vaidastal/DZF-6020-UV-power-addon/README.md

# DZF-6020-UV-power-addon
Addon for DZF-6020 vacuum UV post-curing chamber to adjust light sources and their radiant flux.

---
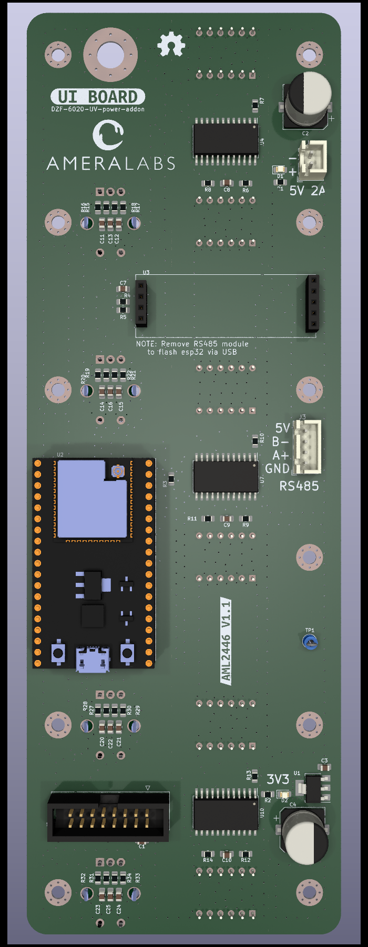
[picture p1: gen/img_3d_ui_front.png]

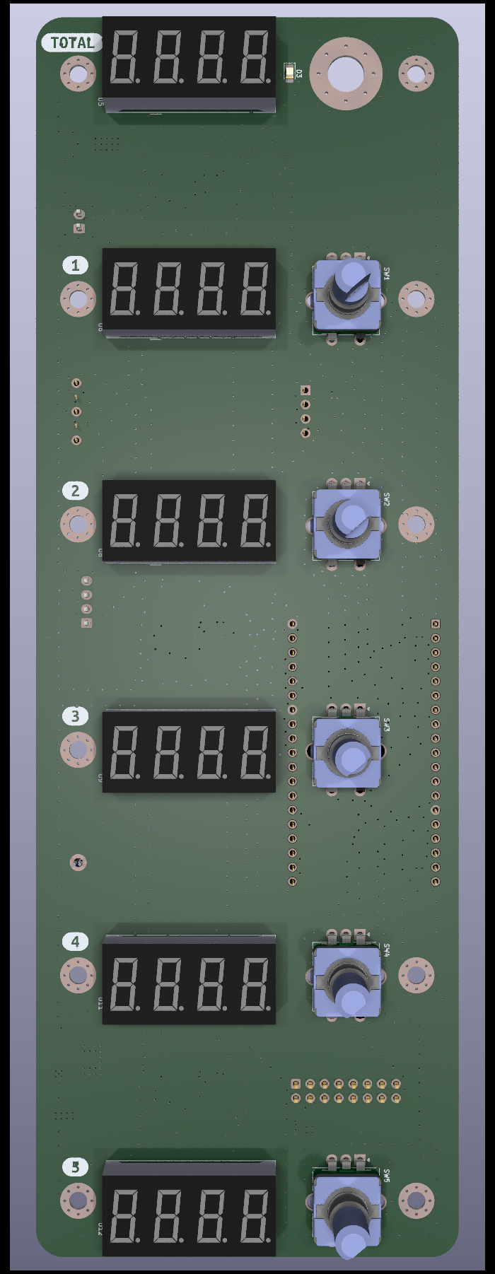
[picture p2: gen/img_3d_ui_back.png]

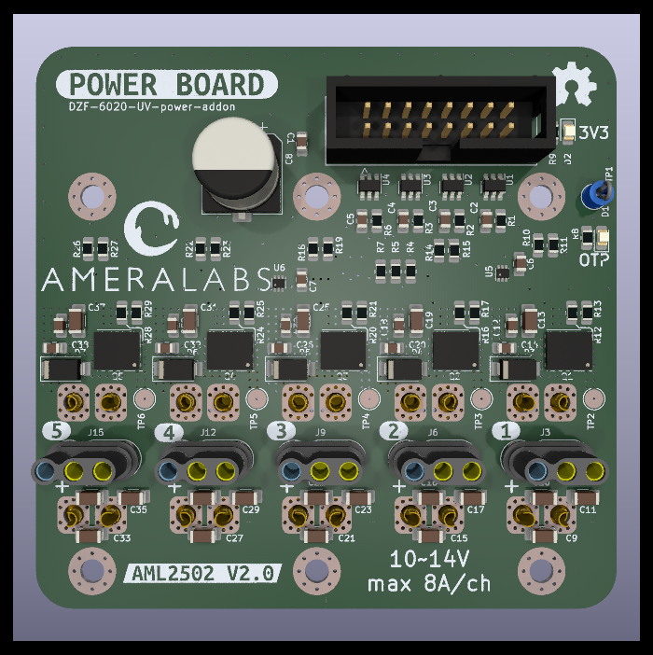
[picture p3: gen/img_3d_pwr_front.png]

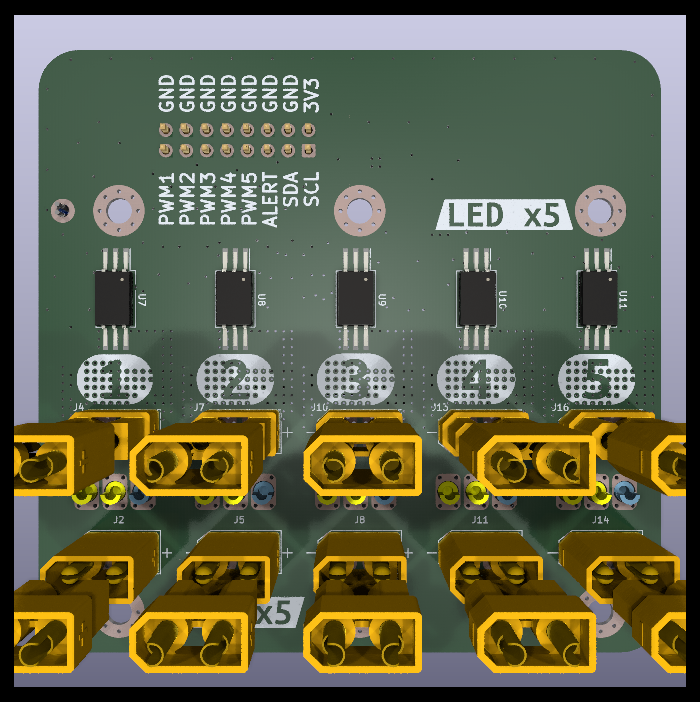
[picture p4: gen/img_3d_pwr_back.png]


Dev NOTE: before commit, run `./kibot.sh` to regenerate documentation, bom, gerbers and other assets.

* [UI schematics](gen/schematics_ui.pdf)
* [power schematics](gen/schematics_pwr.pdf)
* [pcb.pdf with dimensions](gen/pcb.pdf)
