vaidastal/DZF-6020-UV-power-addon/gen/schematics_pwr.pdf

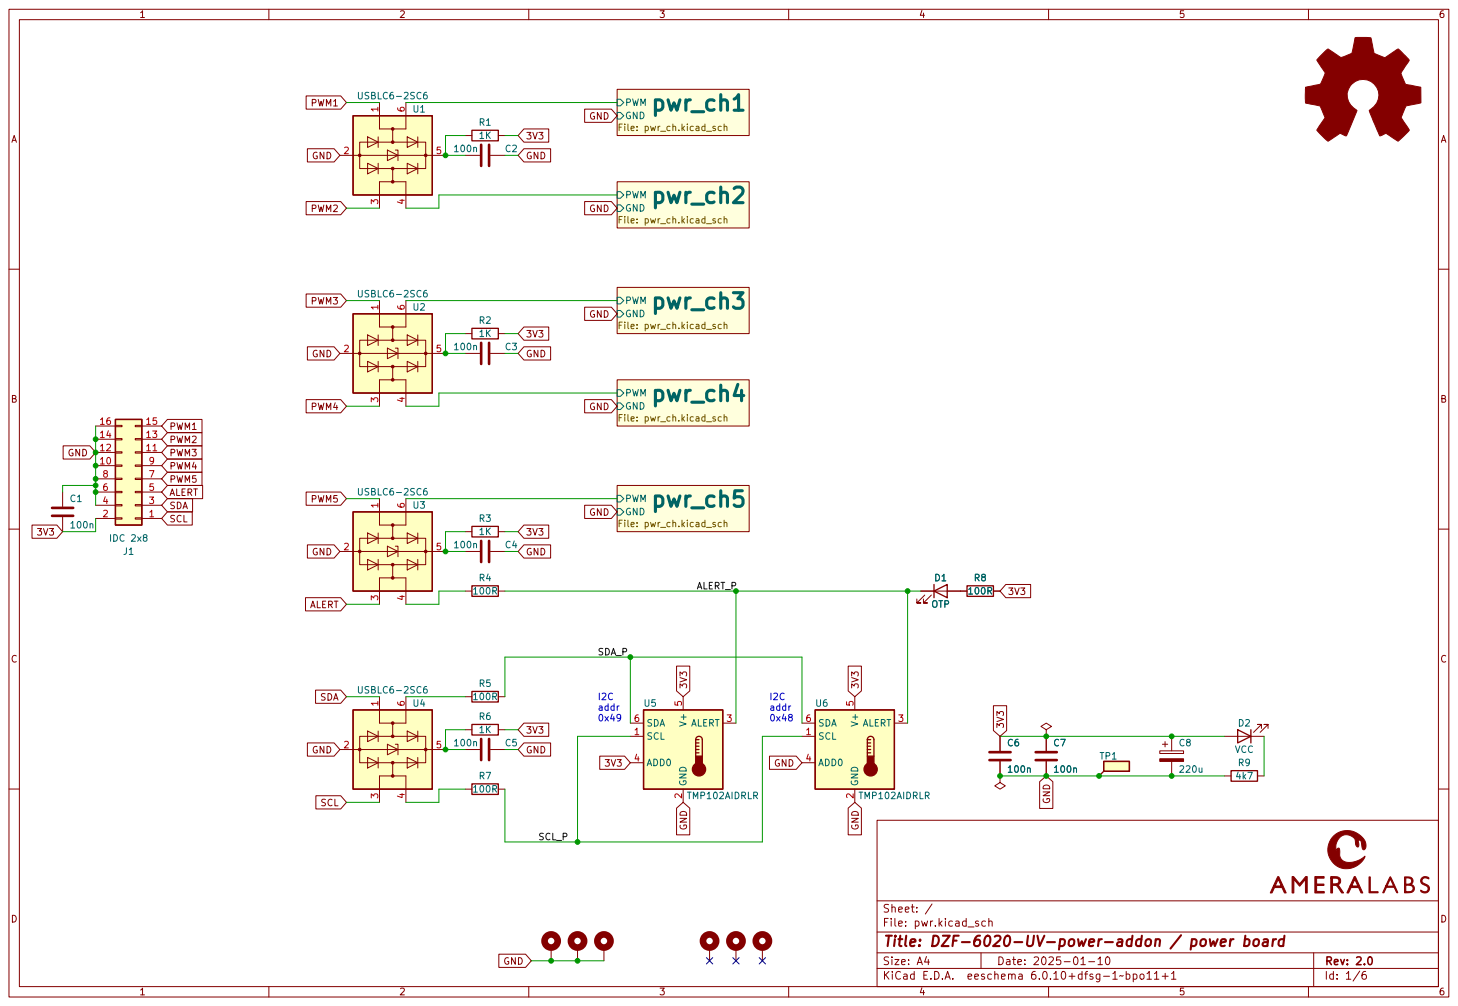
[picture p5: page 1]

File: pwr.kicad_sch Sheet: / PWM

Id: 1/6 Title: DZF-6020-UV-power-addon / power board

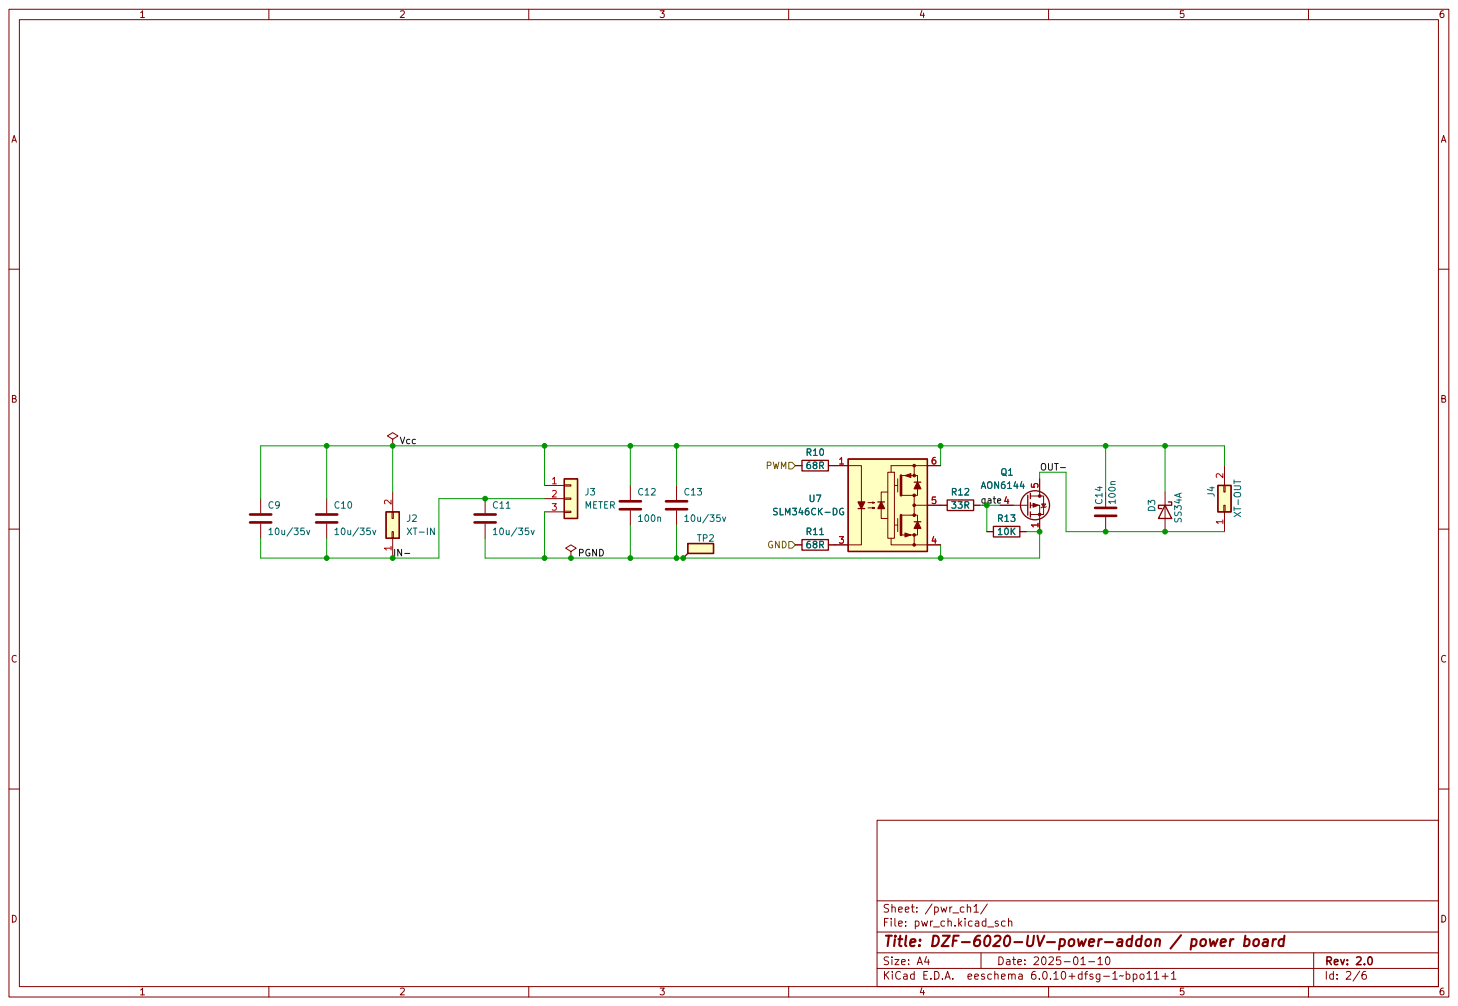
[picture p6: page 2]

File: pwr_ch.kicad_sch
Id: 2/6 Title: DZF-6020-UV-power-addon / power board

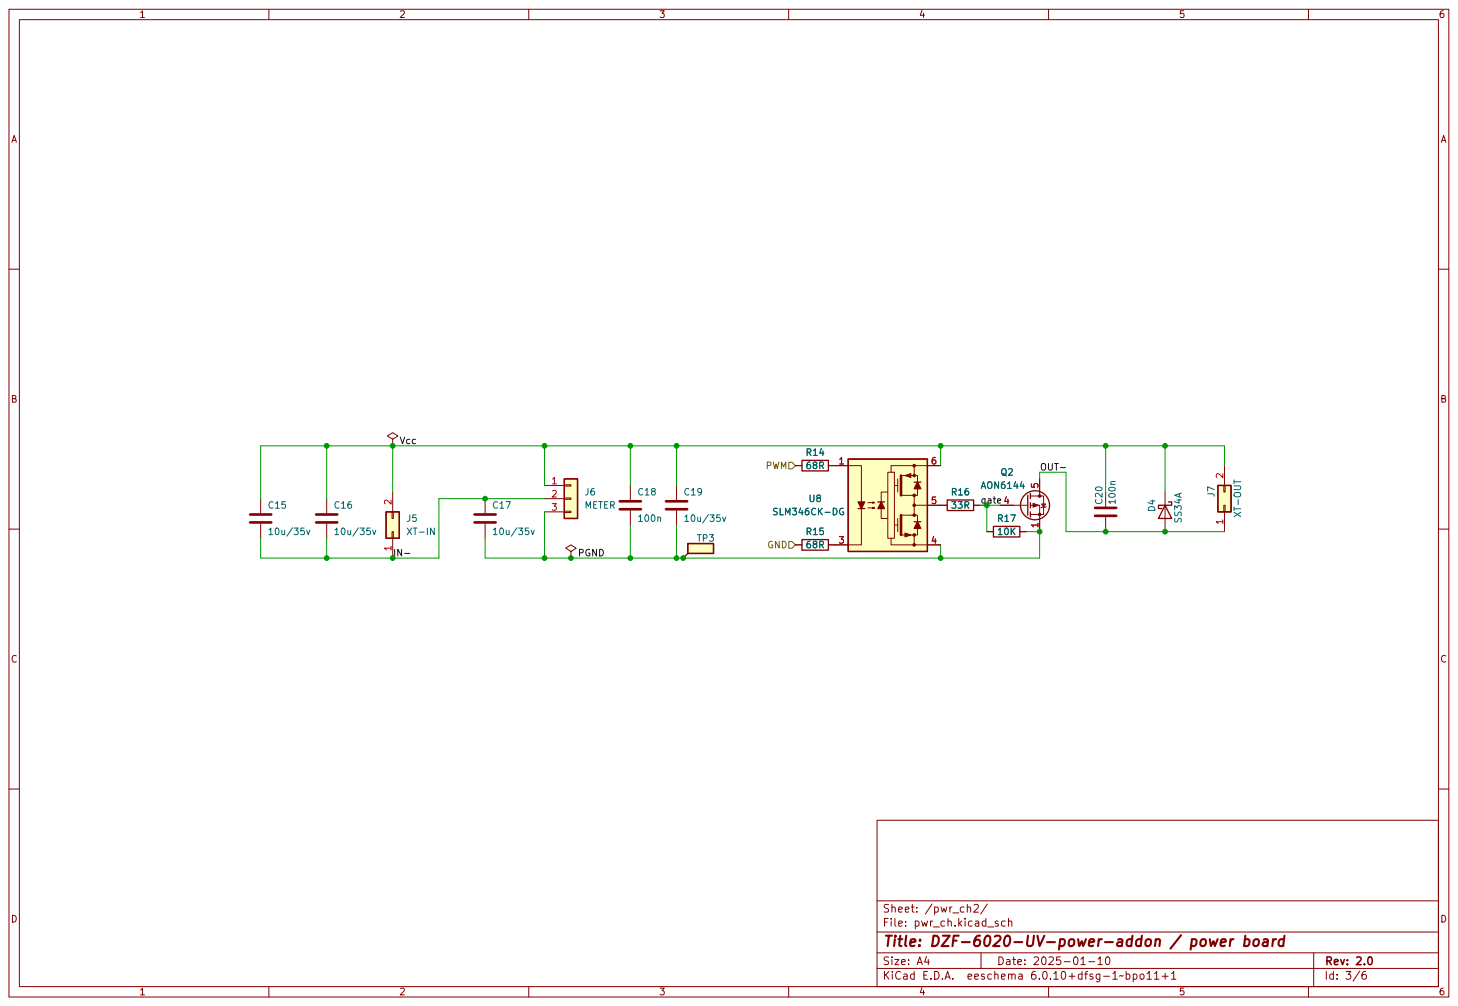
[picture p7: page 3]

File: pwr_ch.kicad_sch
Id: 3/6 Title: DZF-6020-UV-power-addon / power board

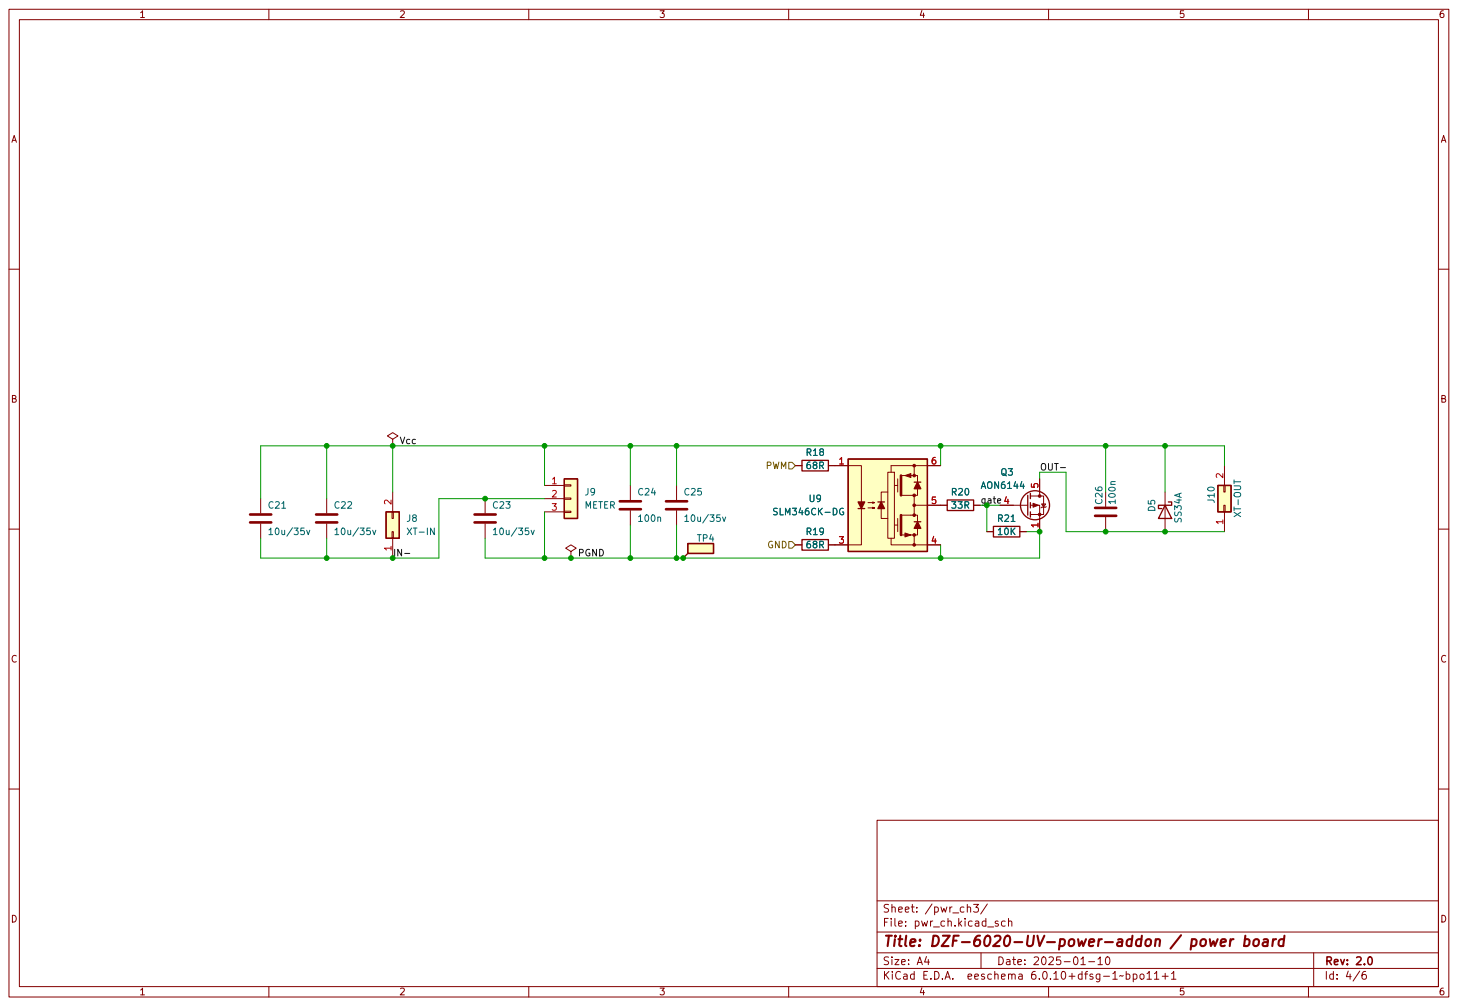
[picture p8: page 4]

File: pwr_ch.kicad_sch
Id: 4/6 Title: DZF-6020-UV-power-addon / power board

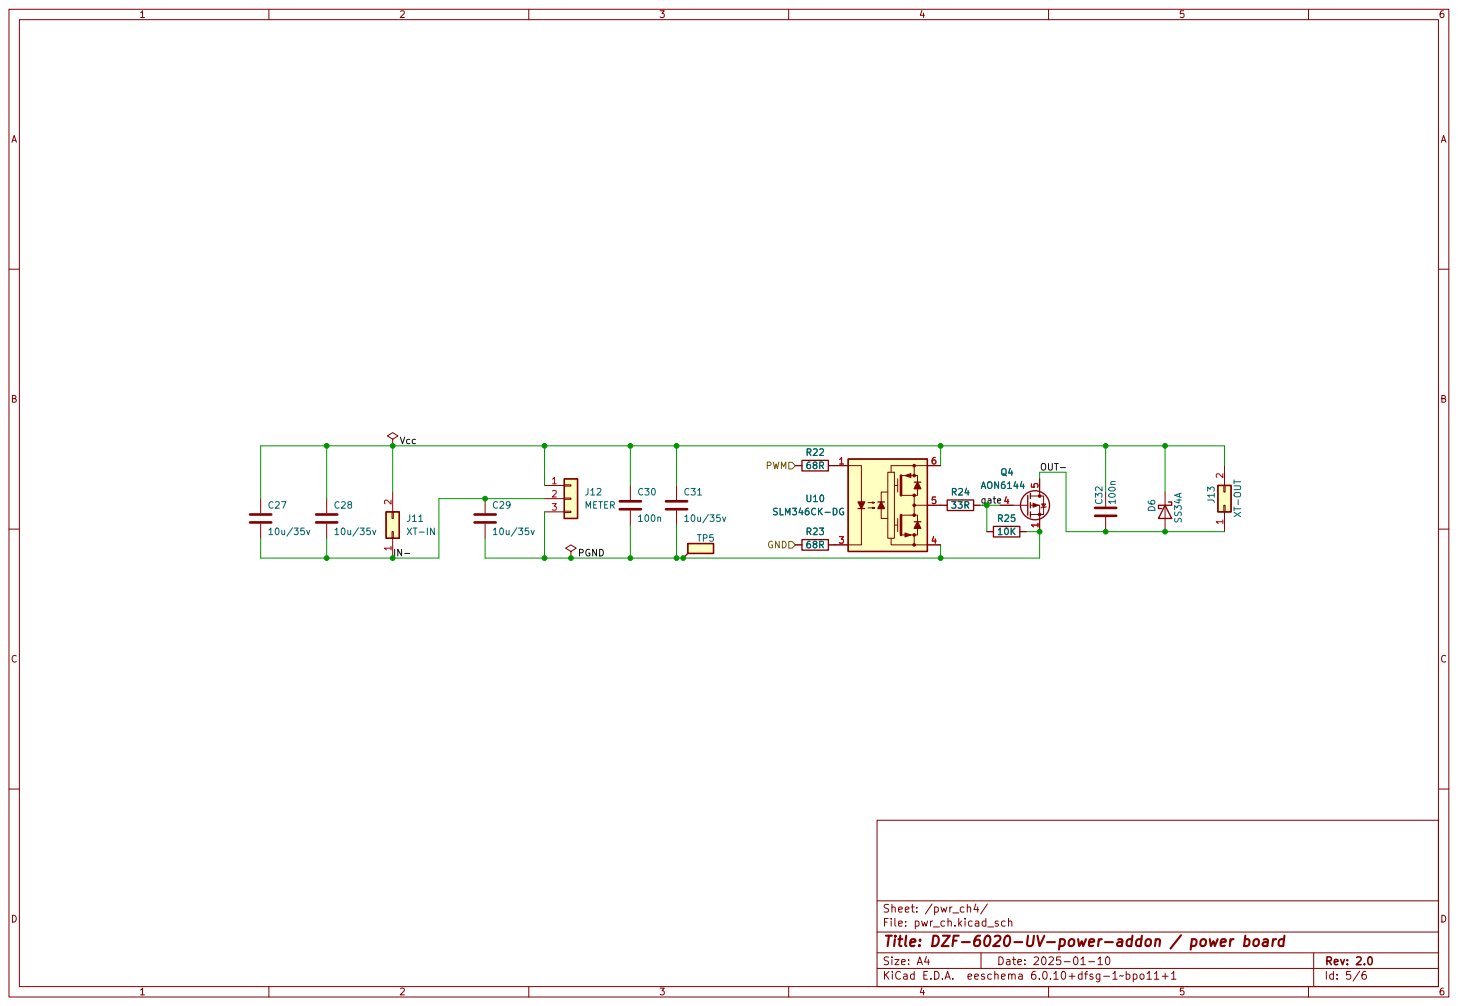
[picture p9: page 5]

File: pwr_ch.kicad_sch
Id: 5/6 Title: DZF-6020-UV-power-addon / power board

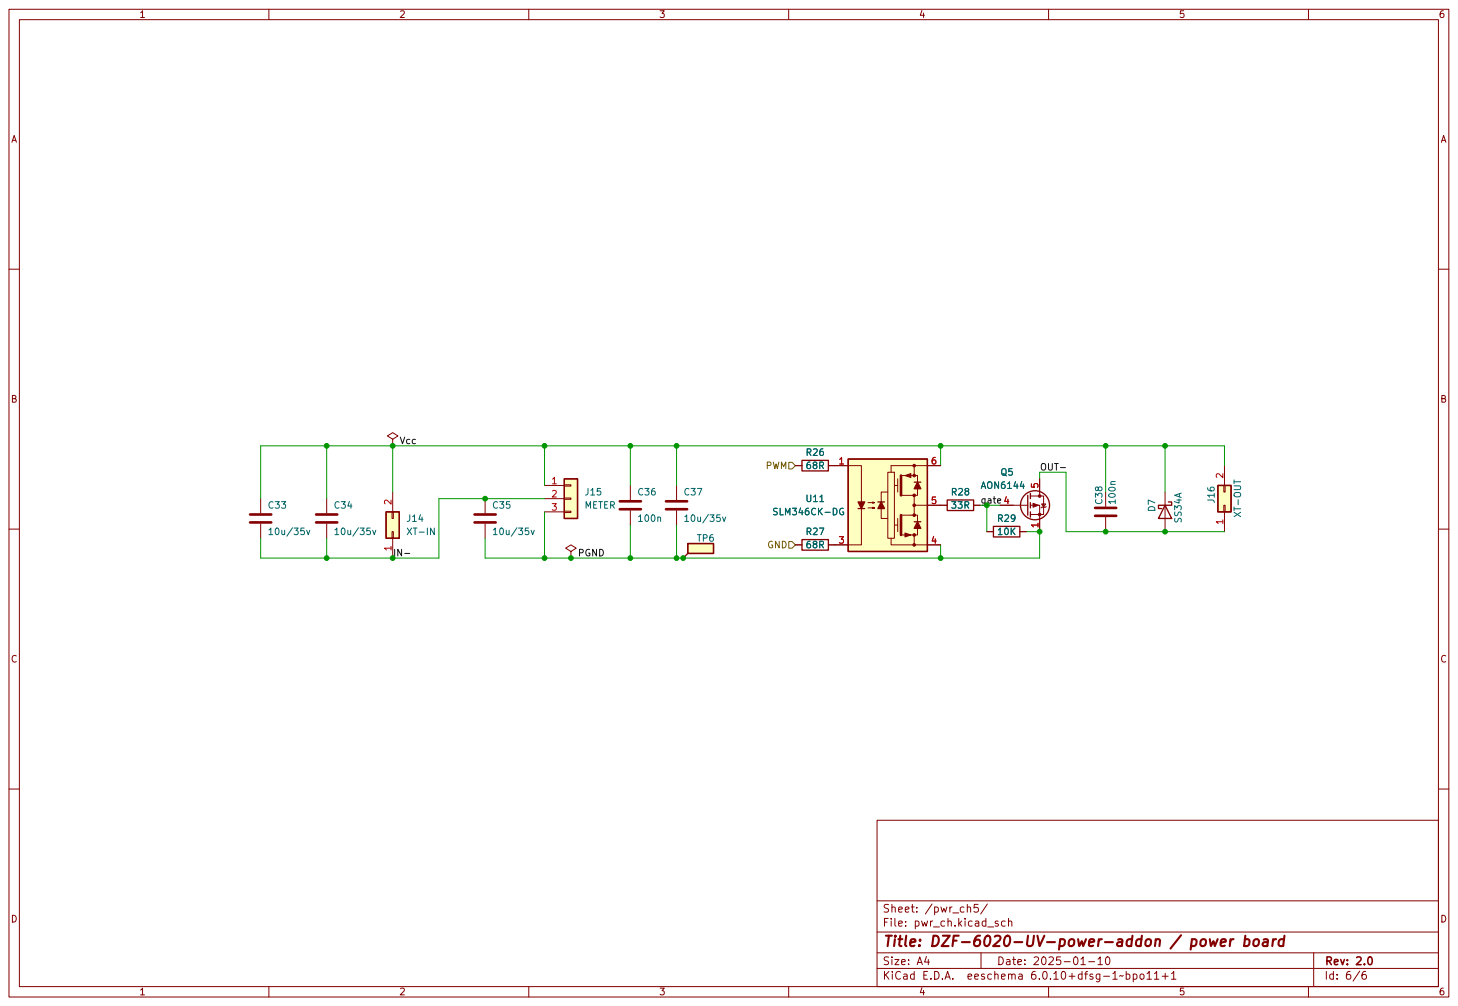
[picture p10: page 6]

File: pwr_ch.kicad_sch
Id: 6/6 Title: DZF-6020-UV-power-addon / power board
