vaidastal/DZF-6020-UV-power-addon/gen/schematics_ui.pdf

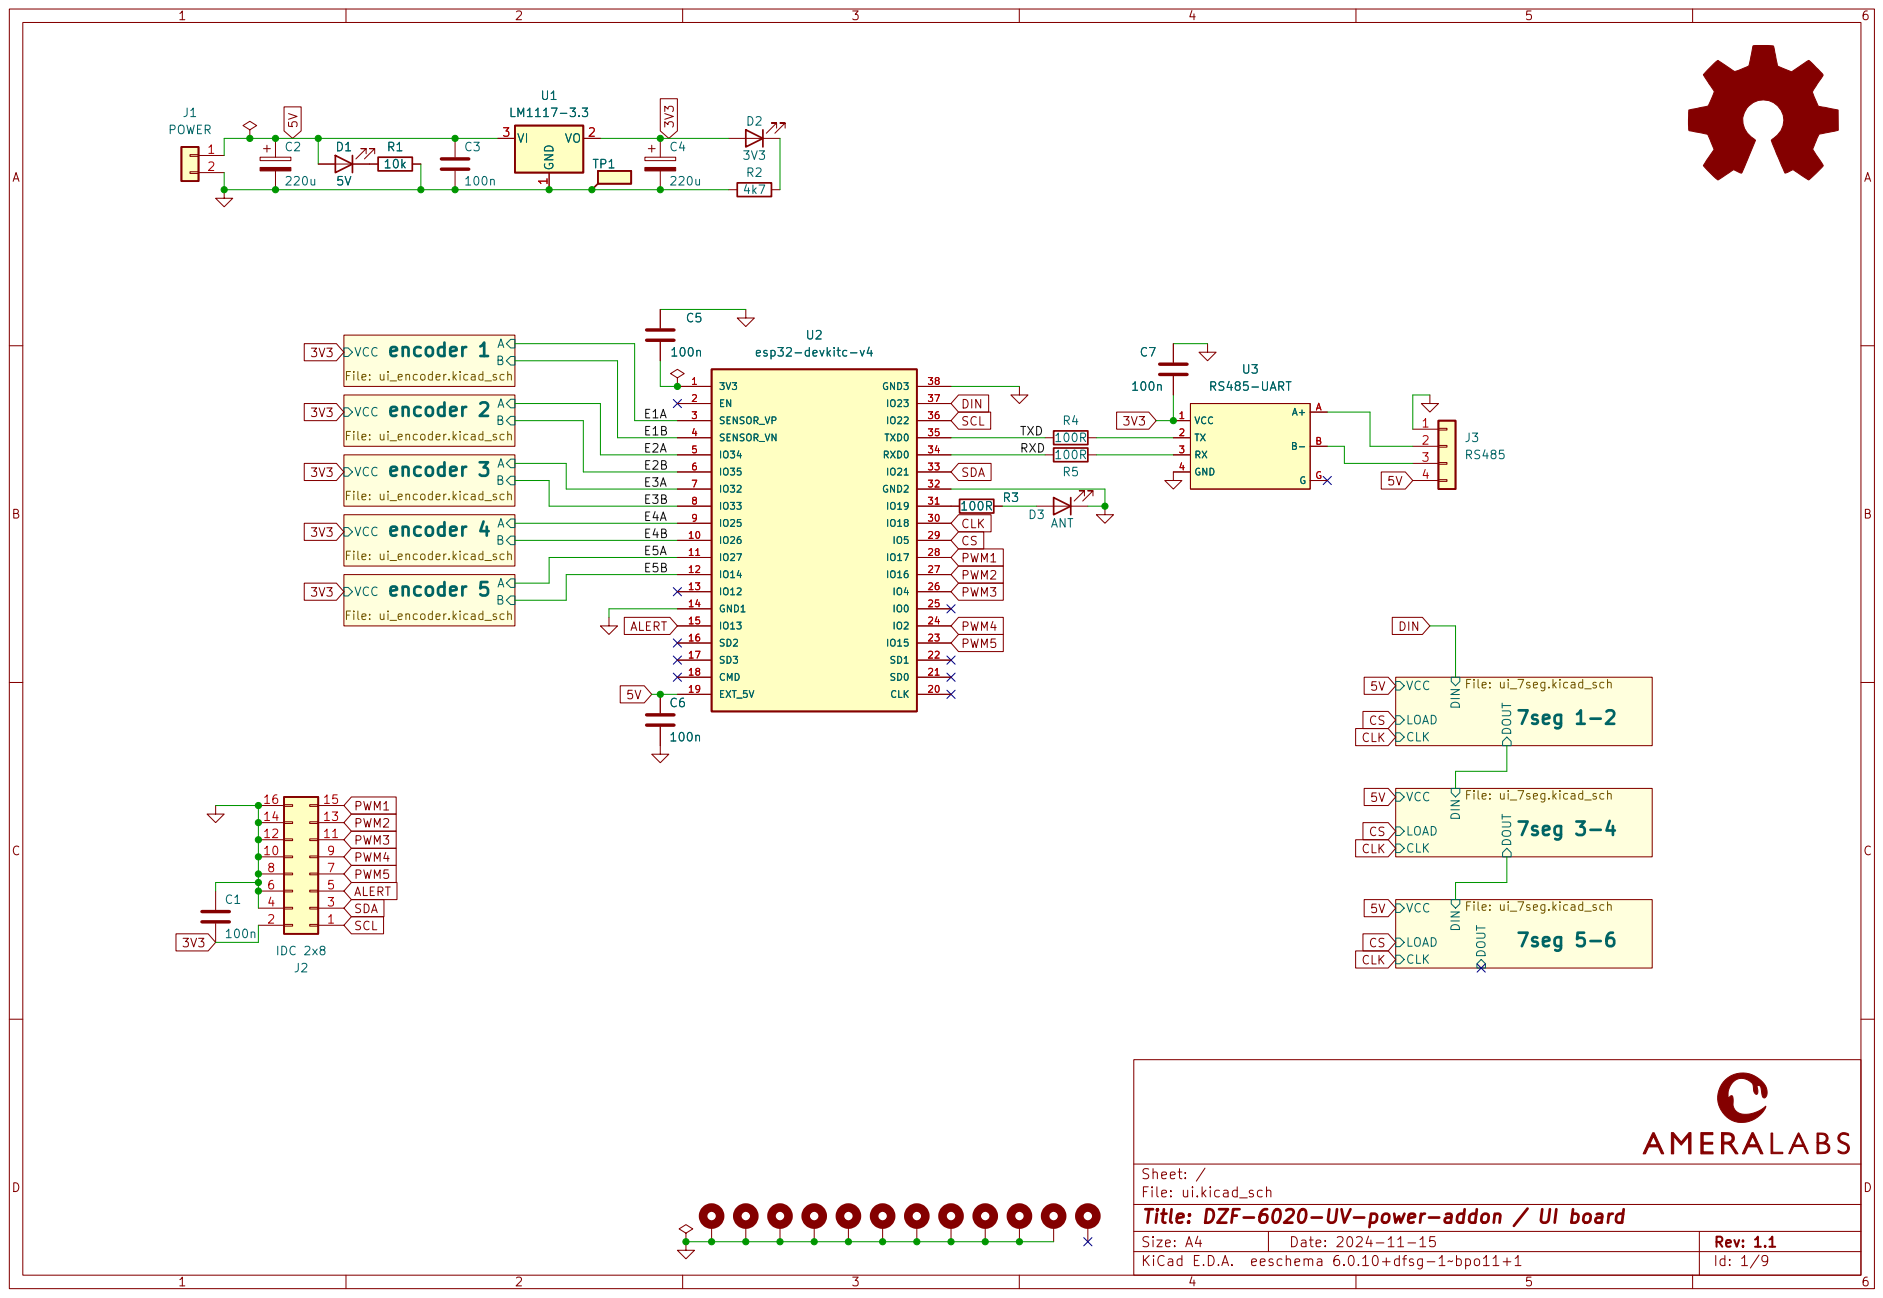
[picture p11: page 1]

14 | 13
12 | 11
10 | 9

File: ui.kicad_sch Sheet: /
Id: 1/9 Title: DZF-6020-UV-power-addon / UI board

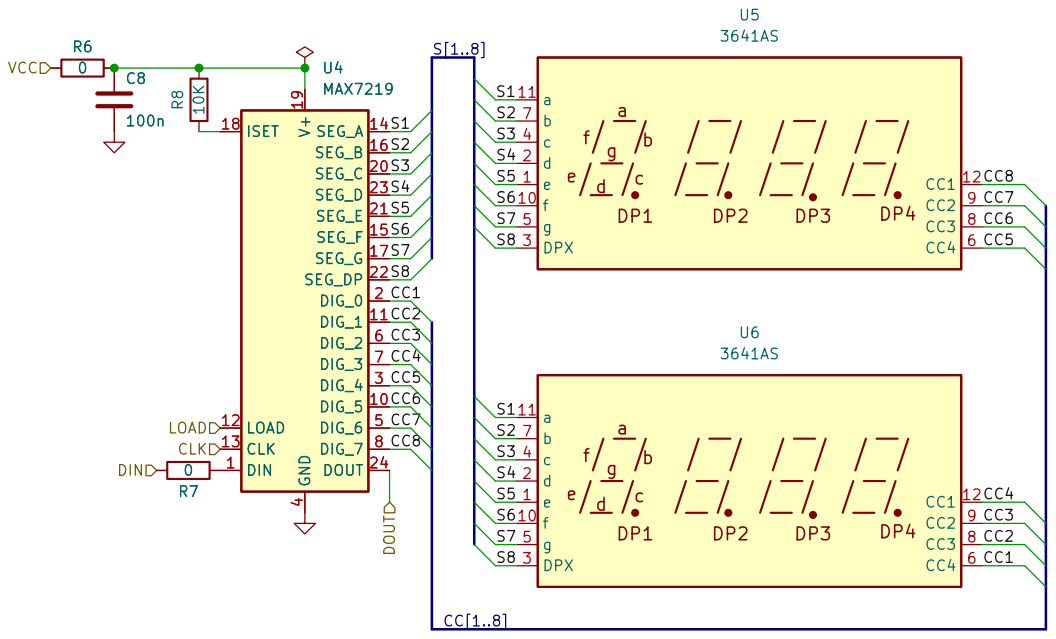
[picture p12: page 2]

Sheet: /7seg 1-2/
File: ui_7seg.kicad_sch
Id: 2/9 Title: DZF-6020-UV-power-addon / UI board

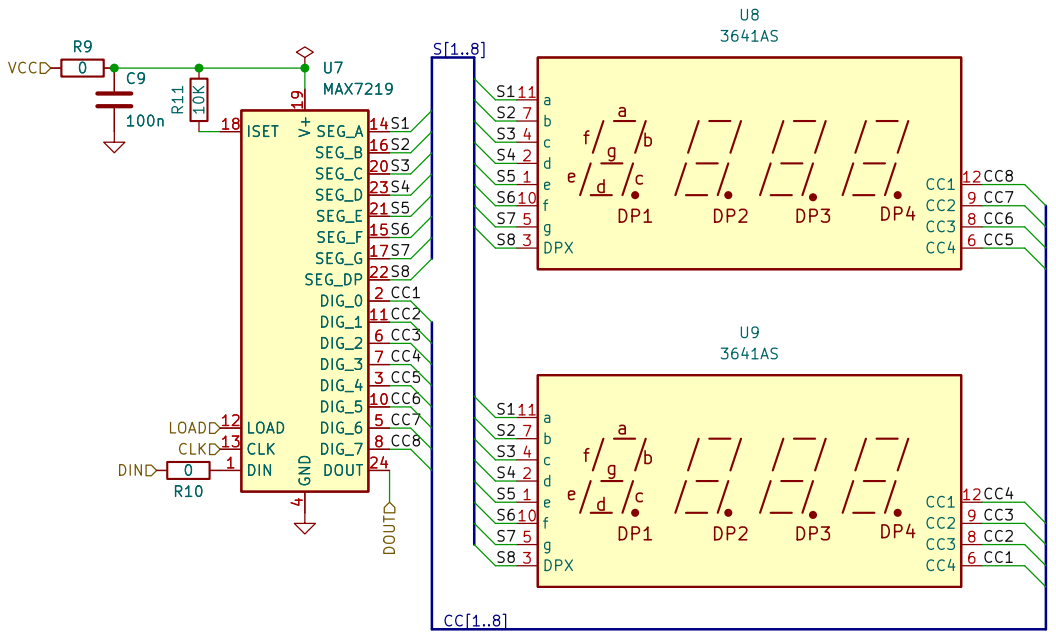
[picture p13: page 3]

Sheet: /7seg 3-4/
File: ui_7seg.kicad_sch
Id: 3/9 Title: DZF-6020-UV-power-addon / UI board

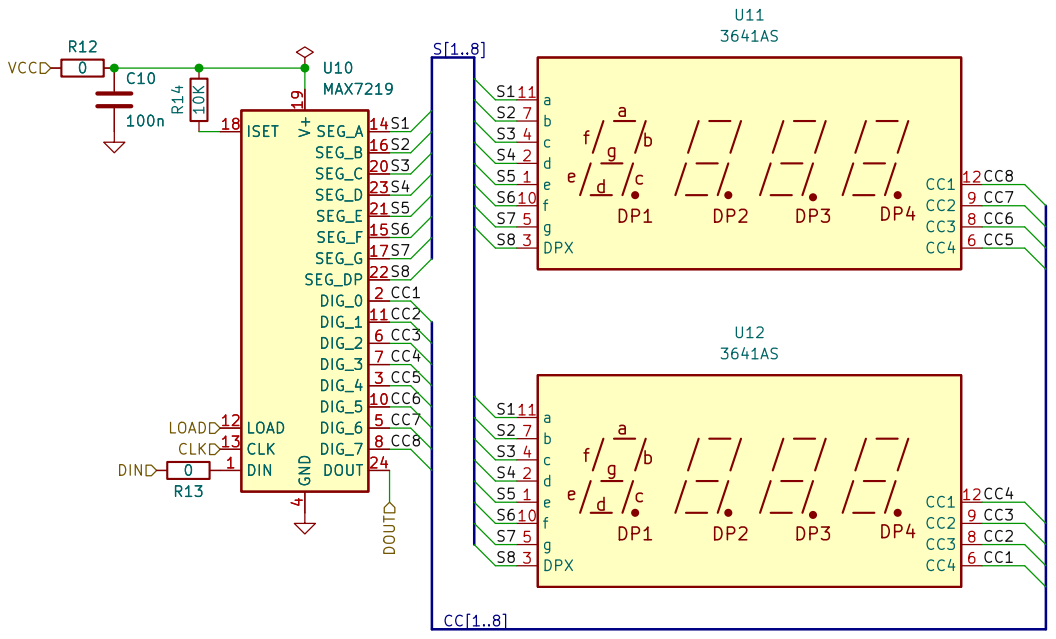
[picture p14: page 4]

Sheet: /7seg 5-6/
File: ui_7seg.kicad_sch
Id: 4/9 Title: DZF-6020-UV-power-addon / UI board

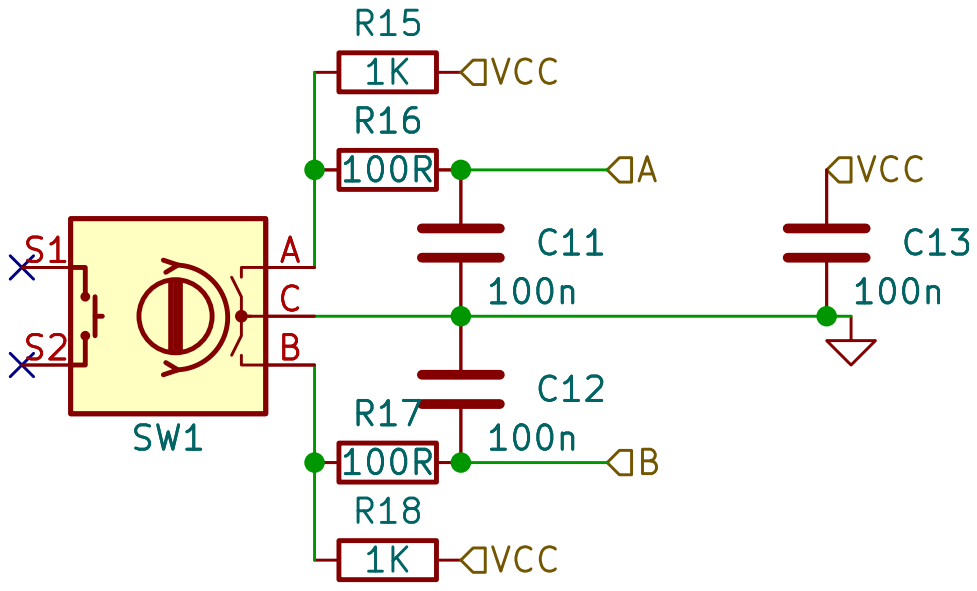
[picture p15: page 5]

Id: 5/9 Title: DZF-6020-UV-power-addon / UI board

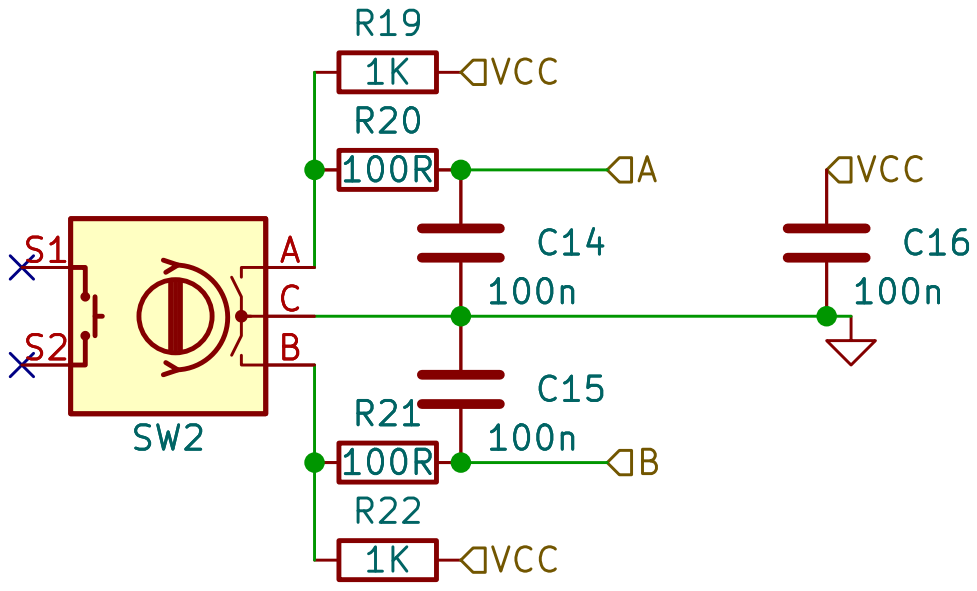
[picture p16: page 6]

Id: 6/9 Title: DZF-6020-UV-power-addon / UI board

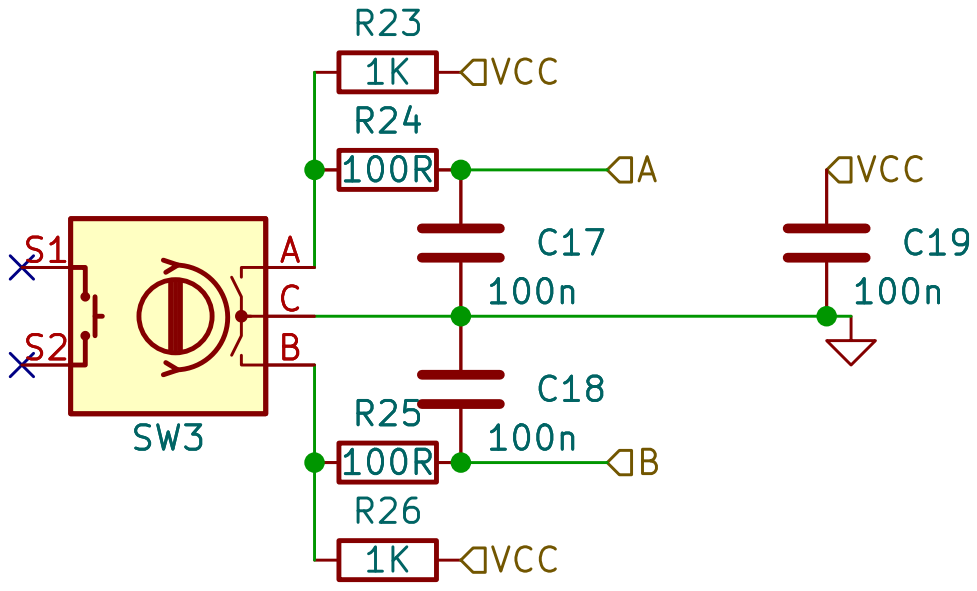
[picture p17: page 7]

Id: 7/9 Title: DZF-6020-UV-power-addon / UI board

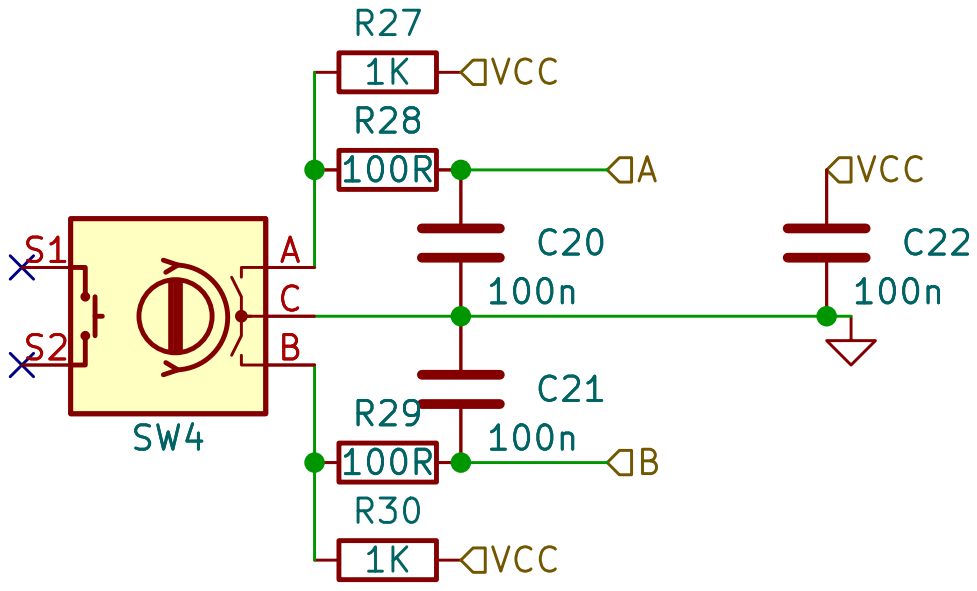
[picture p18: page 8]

Id: 8/9 Title: DZF-6020-UV-power-addon / UI board

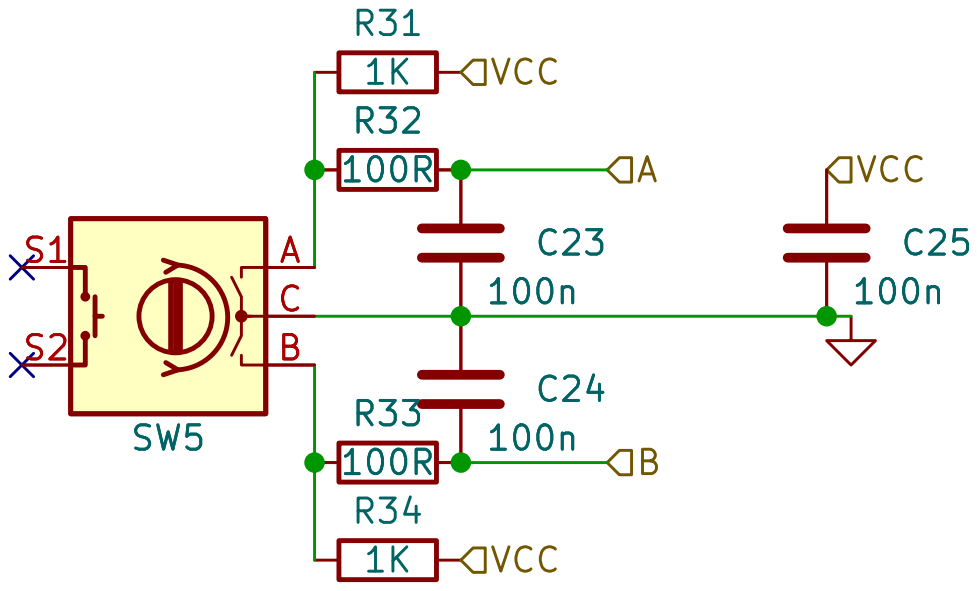
[picture p19: page 9]

Id: 9/9 Title: DZF-6020-UV-power-addon / UI board
