vaidastal/DZF-6020-UV-power-addon/gen/pcb.pdf

# DZF-6020-UV-power-addon

5V 2A

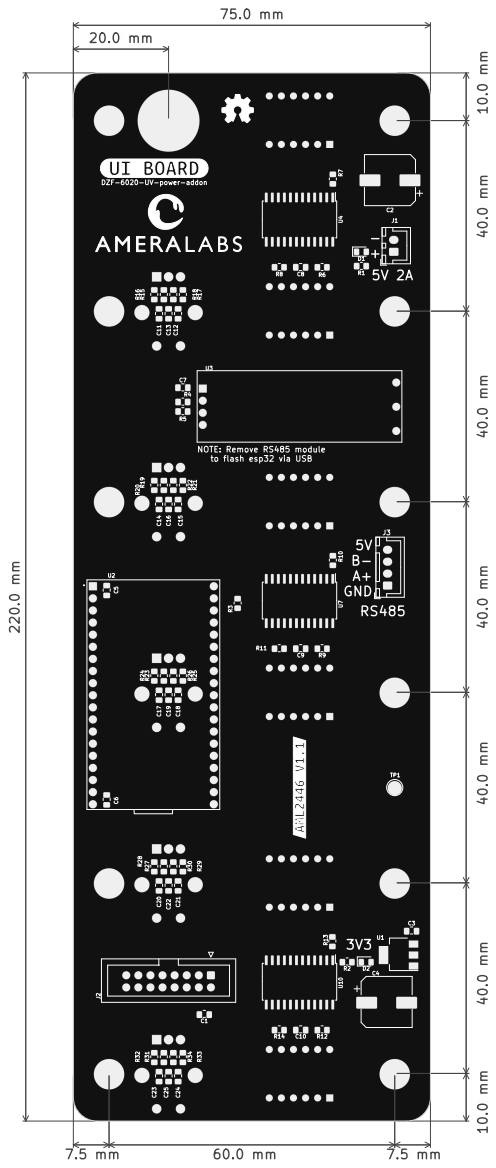
[picture p20: page 1]

NOTE: Remove RS485 module
to flash esp32 via USB

77.5 mm

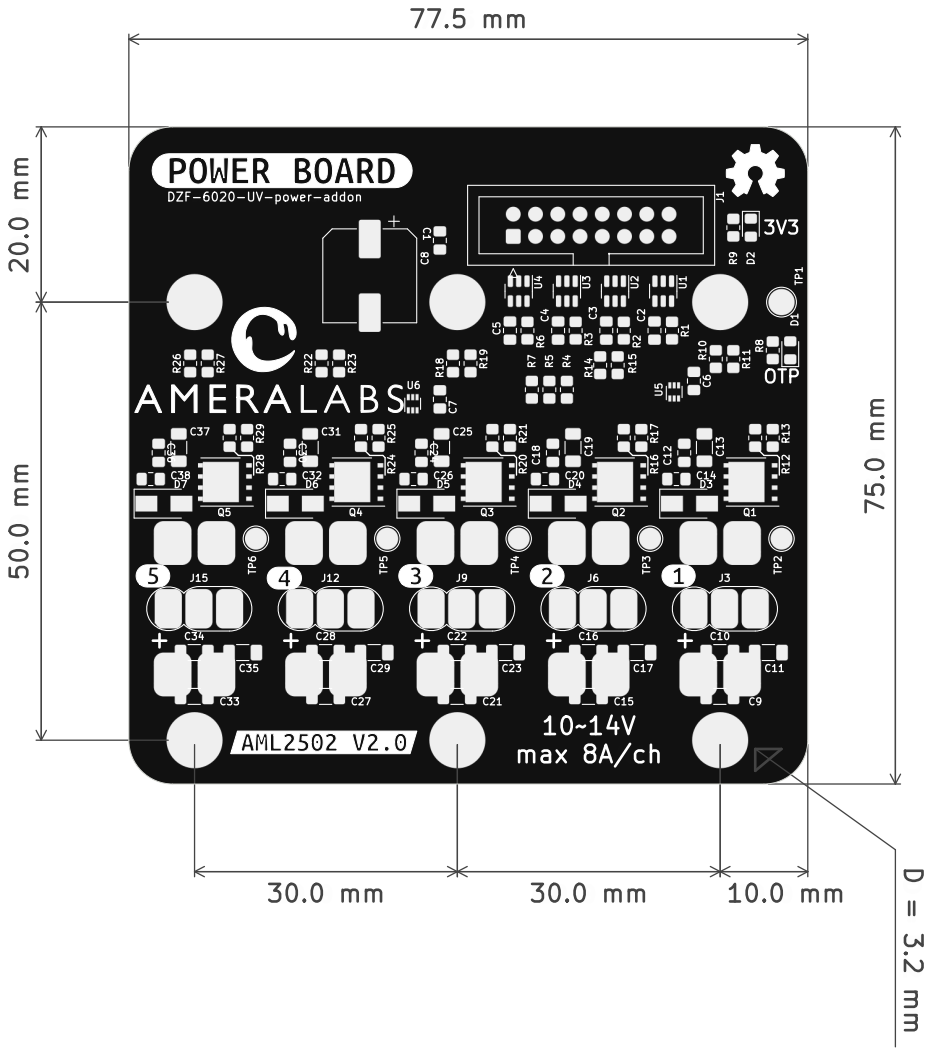
[picture p21: page 2]

DZF-6020-UV-power-addon
