vaidastal/DZF-6020-UV-power-addon/project/pwr.kicad_pcb

## KiCad design project/pwr.kicad_pcb (2025-01-10)

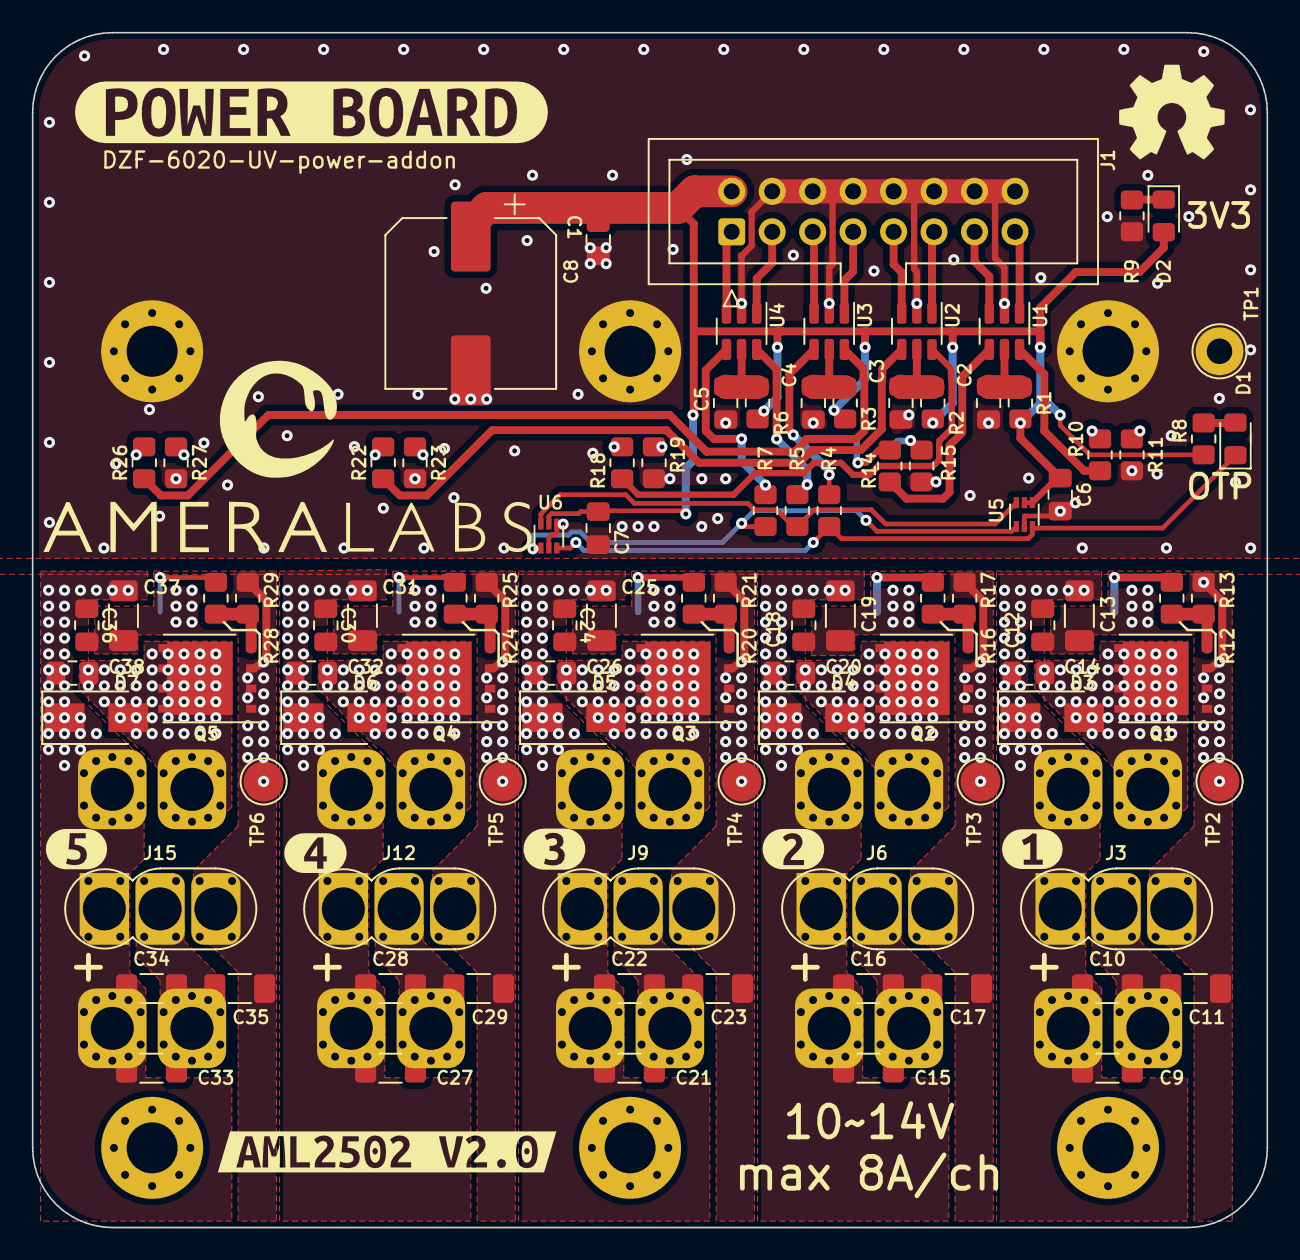
[picture p22: board pwr.kicad_pcb from above]

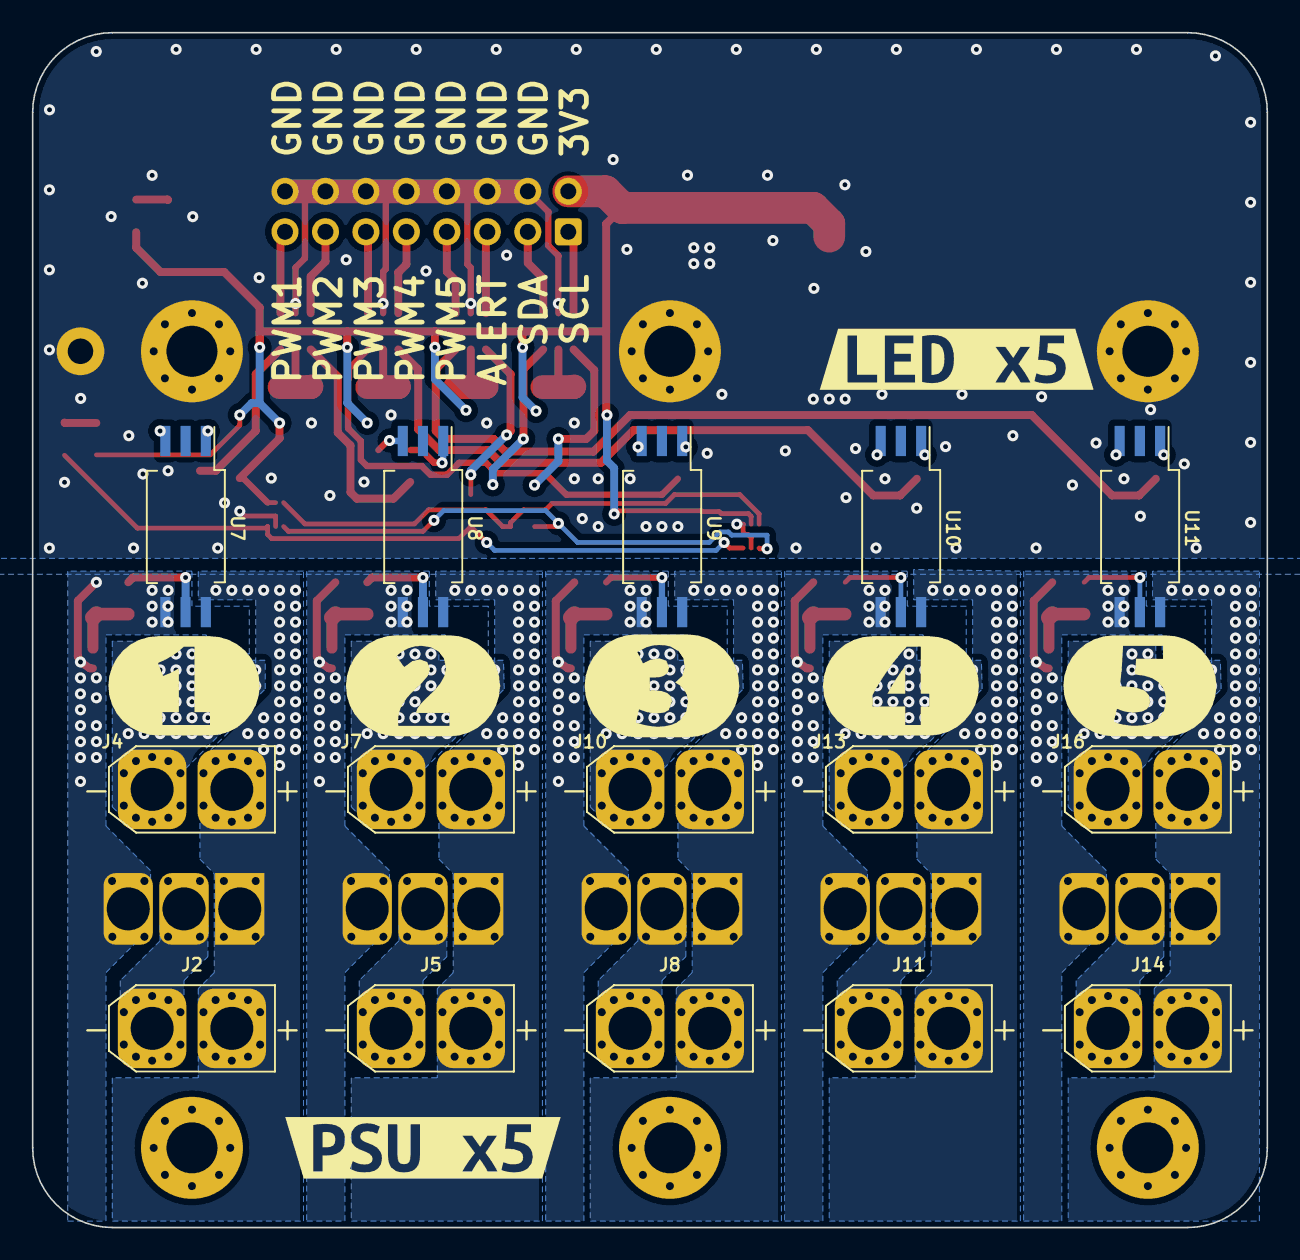
[picture p23: board pwr.kicad_pcb from below]

Board: 2 copper layers, 77.5 x 75.0 mm, 134 parts (22 on the bottom side), 67 nets.

Parts:
C1, C2, C3, C4, C5, C6, C7, C12, C14, C18, C20, C24, C26, C30, C32, C36, C38: 100n; C_0805_2012Metric_Pad1.18x1.45mm_HandSolder
C8: 220u; CP_Elec_10x10.5
C9, C10, C11, C13, C15, C16, C17, C19, C21, C22, C23, C25, C27, C28, C29, C31, C33, C34, C35, C37: 10u/35v; C_1206_3216Metric_Pad1.33x1.80mm_HandSolder
D1: OTP; LED_0805_2012Metric_Pad1.15x1.40mm_HandSolder
D2: VCC; LED_0805_2012Metric_Pad1.15x1.40mm_HandSolder
D3, D4, D5, D6, D7: SS34A; D_SMA
G1: logo_w_text; logo_ameralab_w_text_30x12_silk
G2: Logo_Open_Hardware_Large; OSHW-Symbol_6.7x6mm_SilkScreen
H1, H2, H3, H4, H5, H6: MountingHole_Pad; MountingHole_3.2mm_M3_Pad_Via
J1: IDC 2x8; IDC-Header_2x08_P2.54mm_Vertical
J2, J5, J8, J11, J14: XT-IN; XT30U-M
J3, J6, J9, J12, J15: METER; MR30-F
J4, J7, J10, J13, J16: XT-OUT; XT30U-F
Q1, Q2, Q3, Q4, Q5: AON6144; AO_DFN-8-1EP_5.55x5.2mm_P1.27mm_EP4.12x4.6mm
R1, R2, R3, R6: 1K; R_0805_2012Metric_Pad1.20x1.40mm_HandSolder
R4, R5, R7, R8: 100R; R_0805_2012Metric_Pad1.20x1.40mm_HandSolder
R9: 4k7; R_0805_2012Metric_Pad1.20x1.40mm_HandSolder
R10, R11, R14, R15, R18, R19, R22, R23, R26, R27: 68R; R_0805_2012Metric_Pad1.20x1.40mm_HandSolder
R12, R16, R20, R24, R28: 33R; R_0805_2012Metric_Pad1.20x1.40mm_HandSolder
R13, R17, R21, R25, R29: 10K; R_0805_2012Metric_Pad1.20x1.40mm_HandSolder
TP1: TP_GND; TestPoint_Loop_D2.60mm_Drill1.6mm_Beaded
TP2, TP3, TP4, TP5, TP6: TP_GND; TestPoint_Pad_D2.5mm
U1, U2, U3, U4: USBLC6-2SC6; SOT-23-6
U5, U6: TMP102AIDRLR; SOT-563
U7, U8, U9, U10, U11: SLM346CK-DG; SSO-6_6.8x4.6mm_P1.27mm_Clearance8mm
kibuzzard-66D08EDB: G***; kibuzzard-66D08EDB
kibuzzard-66D17CEB: G***; kibuzzard-66D17CEB
kibuzzard-66D17D14: G***; kibuzzard-66D17D14
kibuzzard-6705D93C: G***; kibuzzard-6705D93C
kibuzzard-6705D97C: G***; kibuzzard-6705D97C
kibuzzard-6705D925: G***; kibuzzard-6705D925
kibuzzard-6705D966: G***; kibuzzard-6705D966
kibuzzard-6705D971: G***; kibuzzard-6705D971
kibuzzard-6736C6C3: G***; kibuzzard-6736C6C3
kibuzzard-6736C6D1: G***; kibuzzard-6736C6D1
kibuzzard-6736C6DD: G***; kibuzzard-6736C6DD
kibuzzard-6736C6EF: G***; kibuzzard-6736C6EF
kibuzzard-6736C676: G***; kibuzzard-6736C676
kibuzzard-6780C605: G***; kibuzzard-6780C605

Connections:
3V3: C1.2, C6.1, C7.1, C8.1, D2.2 (A), J1.2, R1.2, R2.2, R3.2, R6.2, R8.2, U5.4 (ADD0), U5.5 (V+), U6.5 (V+)
/ALERT_P: D1.1 (K), R4.2, U5.3 (ALERT), U6.3 (ALERT)
/SCL_P: R7.2, U5.1 (SCL), U6.1 (SCL)
/SDA_P: R5.2, U5.6 (SDA), U6.6 (SDA)
/pwr_ch1/IN-: C9.2, C10.2, C11.1, J2.1, J3.2
/pwr_ch1/OUT-: C14.2, D3.2 (A), J4.1, Q1.5 (D)
/pwr_ch1/PGND: C11.2, C12.2, C13.2, J3.3, Q1.1 (S), Q1.2 (S), Q1.3 (S), R13.2, TP2.1, U7.4 (VEE)
/pwr_ch1/PWM: R10.1, U1.6 (I/O1)
/pwr_ch1/Vcc: C9.1, C10.1, C12.1, C13.1, C14.1, D3.1 (K), J2.2, J3.1, J4.2, U7.6 (VCC)
/pwr_ch1/gate: Q1.4 (G), R12.2, R13.1
/pwr_ch2/IN-: C15.2, C16.2, C17.1, J5.1, J6.2
/pwr_ch2/OUT-: C20.2, D4.2 (A), J7.1, Q2.5 (D)
/pwr_ch2/PGND: C17.2, C18.2, C19.2, J6.3, Q2.1 (S), Q2.2 (S), Q2.3 (S), R17.2, TP3.1, U8.4 (VEE)
/pwr_ch2/PWM: R14.1, U1.4 (I/O2)
/pwr_ch2/Vcc: C15.1, C16.1, C18.1, C19.1, C20.1, D4.1 (K), J5.2, J6.1, J7.2, U8.6 (VCC)
/pwr_ch2/gate: Q2.4 (G), R16.2, R17.1
/pwr_ch3/IN-: C21.2, C22.2, C23.1, J8.1, J9.2
/pwr_ch3/OUT-: C26.2, D5.2 (A), J10.1, Q3.5 (D)
/pwr_ch3/PGND: C23.2, C24.2, C25.2, J9.3, Q3.1 (S), Q3.2 (S), Q3.3 (S), R21.2, TP4.1, U9.4 (VEE)
/pwr_ch3/PWM: R18.1, U2.6 (I/O1)
/pwr_ch3/Vcc: C21.1, C22.1, C24.1, C25.1, C26.1, D5.1 (K), J8.2, J9.1, J10.2, U9.6 (VCC)
/pwr_ch3/gate: Q3.4 (G), R20.2, R21.1
/pwr_ch4/IN-: C27.2, C28.2, C29.1, J11.1, J12.2
/pwr_ch4/OUT-: C32.2, D6.2 (A), J13.1, Q4.5 (D)
/pwr_ch4/PGND: C29.2, C30.2, C31.2, J12.3, Q4.1 (S), Q4.2 (S), Q4.3 (S), R25.2, TP5.1, U10.4 (VEE)
/pwr_ch4/PWM: R22.1, U2.4 (I/O2)
/pwr_ch4/Vcc: C27.1, C28.1, C30.1, C31.1, C32.1, D6.1 (K), J11.2, J12.1, J13.2, U10.6 (VCC)
/pwr_ch4/gate: Q4.4 (G), R24.2, R25.1
/pwr_ch5/IN-: C33.2, C34.2, C35.1, J14.1, J15.2
/pwr_ch5/OUT-: C38.2, D7.2 (A), J16.1, Q5.5 (D)
/pwr_ch5/PGND: C35.2, C36.2, C37.2, J15.3, Q5.1 (S), Q5.2 (S), Q5.3 (S), R29.2, TP6.1, U11.4 (VEE)
/pwr_ch5/PWM: R26.1, U3.6 (I/O1)
/pwr_ch5/Vcc: C33.1, C34.1, C36.1, C37.1, C38.1, D7.1 (K), J14.2, J15.1, J16.2, U11.6 (VCC)
/pwr_ch5/gate: Q5.4 (G), R28.2, R29.1
ALERT: J1.5, U3.3 (I/O2)
GND: C1.1, C2.2, C3.2, C4.2, C5.2, C6.2, C7.2, C8.2, H1.1, H2.1, H3.1, J1.4, J1.6, J1.8, J1.10, J1.12, J1.14, J1.16, R9.1, R11.1, R15.1, R19.1, R23.1, R27.1, TP1.1, U1.2 (GND), U2.2 (GND), U3.2 (GND), U4.2 (GND), U5.2 (GND), U6.2 (GND), U6.4 (ADD0)
unnamed: C2.1, R1.1, U1.5 (VBUS)
unnamed: C3.1, R2.1, U2.5 (VBUS)
unnamed: C4.1, R3.1, U3.5 (VBUS)
unnamed: C5.1, R6.1, U4.5 (VBUS)
unnamed: D1.2 (A), R8.1
unnamed: D2.1 (K), R9.2
unnamed: R4.1, U3.4 (I/O2)
unnamed: R5.1, U4.6 (I/O1)
unnamed: R7.1, U4.4 (I/O2)
unnamed: R10.2, U7.1 (A)
unnamed: R11.2, U7.3 (C)
unnamed: R12.1, U7.5 (VO)
unnamed: R14.2, U8.1 (A)
unnamed: R15.2, U8.3 (C)
unnamed: R16.1, U8.5 (VO)
unnamed: R18.2, U9.1 (A)
unnamed: R19.2, U9.3 (C)
unnamed: R20.1, U9.5 (VO)
unnamed: R22.2, U10.1 (A)
unnamed: R23.2, U10.3 (C)
unnamed: R24.1, U10.5 (VO)
unnamed: R26.2, U11.1 (A)
unnamed: R27.2, U11.3 (C)
unnamed: R28.1, U11.5 (VO)
PWM1: J1.15, U1.1 (I/O1)
PWM2: J1.13, U1.3 (I/O2)
PWM3: J1.11, U2.1 (I/O1)
PWM4: J1.9, U2.3 (I/O2)
PWM5: J1.7, U3.1 (I/O1)
SCL: J1.1, U4.3 (I/O2)
SDA: J1.3, U4.1 (I/O1)
