vaidastal/DZF-6020-UV-power-addon/project/ui.kicad_pcb

## KiCad design project/ui.kicad_pcb (2024-11-15)

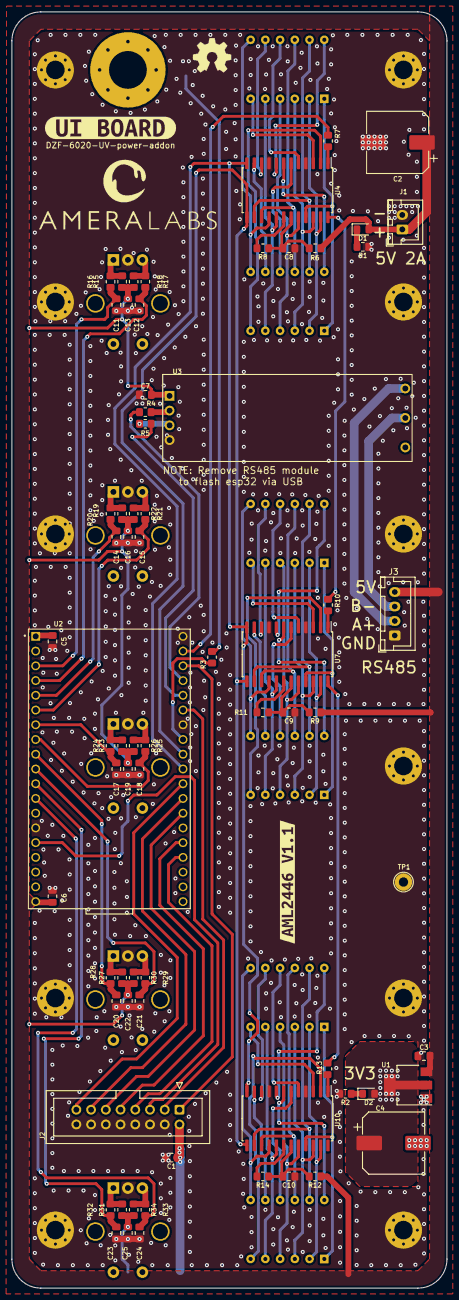
[picture p24: board ui.kicad_pcb from above]

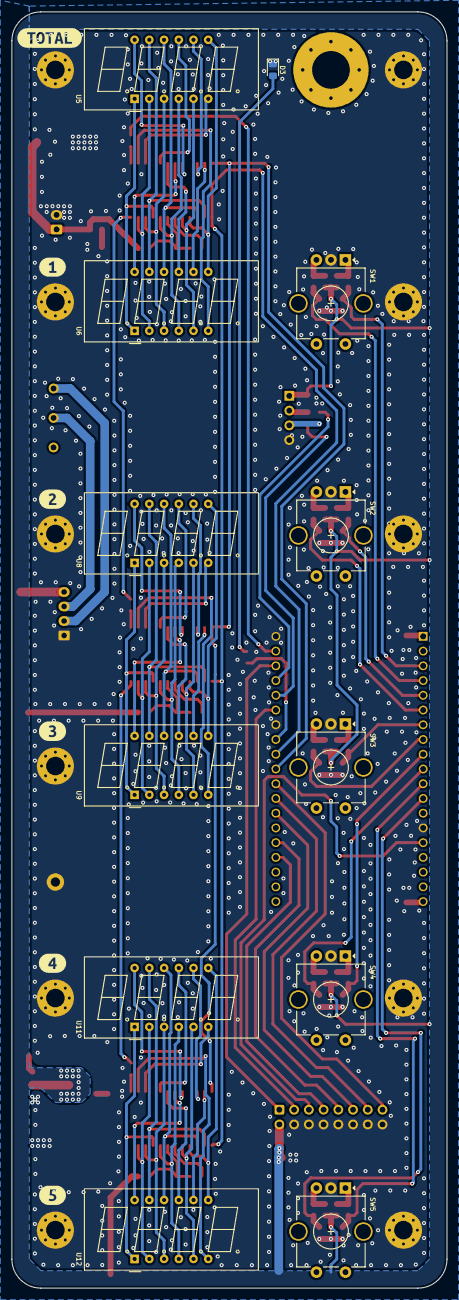
[picture p25: board ui.kicad_pcb from below]

Board: 2 copper layers, 75.0 x 220.0 mm, 105 parts (18 on the bottom side), 104 nets.

Parts:
C1, C3, C5, C6, C7, C8, C9, C10, C11, C12, C13, C14, C15, C16, C17, C18, C19, C20, C21, C22, C23, C24, C25: 100n; C_0805_2012Metric_Pad1.18x1.45mm_HandSolder
C2, C4: 220u; CP_Elec_10x10.5
D1: 5V; LED_0805_2012Metric_Pad1.15x1.40mm_HandSolder
D2: 3V3; LED_0805_2012Metric_Pad1.15x1.40mm_HandSolder
D3: ANT; LED_0805_2012Metric_Pad1.15x1.40mm_HandSolder
G1: logo_w_text; logo_ameralab_w_text_30x12_silk
G2: Logo_Open_Hardware_Large; OSHW-Symbol_6.7x6mm_SilkScreen
H1, H2, H3, H4, H5, H6, H7, H8, H9, H10, H11: MountingHole_Pad; MountingHole_3.2mm_M3_Pad_Via
H12: MountingHole_Pad; MountingHole_6.5mm_Pad_Via
J1: POWER; JST_XH_B2B-XH-A_1x02_P2.50mm_Vertical
J2: IDC 2x8; IDC-Header_2x08_P2.54mm_Vertical
J3: RS485; JST_XH_B4B-XH-A_1x04_P2.50mm_Vertical
R1: 10k; R_0805_2012Metric_Pad1.20x1.40mm_HandSolder
R2: 4k7; R_0805_2012Metric_Pad1.20x1.40mm_HandSolder
R3, R4, R5, R16, R17, R20, R21, R24, R25, R28, R29, R32, R33: 100R; R_0805_2012Metric_Pad1.20x1.40mm_HandSolder
R6, R7, R9, R10, R12, R13: 0; R_0805_2012Metric_Pad1.20x1.40mm_HandSolder
R8, R11, R14: 10K; R_0805_2012Metric_Pad1.20x1.40mm_HandSolder
R15, R18, R19, R22, R23, R26, R27, R30, R31, R34: 1K; R_0805_2012Metric_Pad1.20x1.40mm_HandSolder
SW1, SW2, SW3, SW4, SW5: RotaryEncoder_Switch; RotaryEncoder_Alps_EC11E-Switch_Vertical_H20mm_CircularMoun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
TP1: TP_GND; TestPoint_Loop_D2.60mm_Drill1.6mm_Beaded
U1: LM1117-3.3; SOT-223-3_TabPin2
U2: esp32-devkitc-v4
U3: RS485-UART
U4, U7, U10: MAX7219; SOIC-24W_7.5x15.4mm_P1.27mm
U5, U6, U8, U9, U11, U12: 3641AS
kibuzzard-66DF75FA: G***; kibuzzard-66DF75FA
kibuzzard-66DF760D: G***; kibuzzard-66DF760D
kibuzzard-66DF7589: G***; kibuzzard-66DF7589
kibuzzard-66DF7601: G***; kibuzzard-66DF7601
kibuzzard-66DF7618: G***; kibuzzard-66DF7618
kibuzzard-66DF7626: G***; kibuzzard-66DF7626
kibuzzard-66DFD37B: G***; kibuzzard-66DFD37B
kibuzzard-6736B76D: G***; kibuzzard-6736B76D

Connections:
3V3: C1.2, C4.1, C7.2, C13.1, C16.1, C19.1, C22.1, C25.1, D2.2 (A), J2.2, R15.2, R18.2, R19.2, R22.2, R23.2, R26.2, R27.2, R30.2, R31.2, R34.2, U1.2 (VO), U3.1 (VCC)
5V: C2.1, C3.1, C6.1, D1.2 (A), J1.1, J3.4, R6.1, R9.1, R12.1, U1.3 (VI), U2.19 (EXT_5V)
/7seg 1-2/CC1: U4.2 (DIG_0), U6.6 (CC4)
/7seg 1-2/CC2: U4.11 (DIG_1), U6.8 (CC3)
/7seg 1-2/CC3: U4.6 (DIG_2), U6.9 (CC2)
/7seg 1-2/CC4: U4.7 (DIG_3), U6.12 (CC1)
/7seg 1-2/CC5: U4.3 (DIG_4), U5.6 (CC4)
/7seg 1-2/CC6: U4.10 (DIG_5), U5.8 (CC3)
/7seg 1-2/CC7: U4.5 (DIG_6), U5.9 (CC2)
/7seg 1-2/CC8: U4.8 (DIG_7), U5.12 (CC1)
/7seg 1-2/DOUT: R10.1, U4.24 (DOUT)
/7seg 1-2/S1: U4.14 (SEG_A), U5.11 (a), U6.11 (a)
/7seg 1-2/S2: U4.16 (SEG_B), U5.7 (b), U6.7 (b)
/7seg 1-2/S3: U4.20 (SEG_C), U5.4 (c), U6.4 (c)
/7seg 1-2/S4: U4.23 (SEG_D), U5.2 (d), U6.2 (d)
/7seg 1-2/S5: U4.21 (SEG_E), U5.1 (e), U6.1 (e)
/7seg 1-2/S6: U4.15 (SEG_F), U5.10 (f), U6.10 (f)
/7seg 1-2/S7: U4.17 (SEG_G), U5.5 (g), U6.5 (g)
/7seg 1-2/S8: U4.22 (SEG_DP), U5.3 (DPX), U6.3 (DPX)
/7seg 3-4/CC1: U7.2 (DIG_0), U9.6 (CC4)
/7seg 3-4/CC2: U7.11 (DIG_1), U9.8 (CC3)
/7seg 3-4/CC3: U7.6 (DIG_2), U9.9 (CC2)
/7seg 3-4/CC4: U7.7 (DIG_3), U9.12 (CC1)
/7seg 3-4/CC5: U7.3 (DIG_4), U8.6 (CC4)
/7seg 3-4/CC6: U7.10 (DIG_5), U8.8 (CC3)
/7seg 3-4/CC7: U7.5 (DIG_6), U8.9 (CC2)
/7seg 3-4/CC8: U7.8 (DIG_7), U8.12 (CC1)
/7seg 3-4/DOUT: R13.1, U7.24 (DOUT)
/7seg 3-4/S1: U7.14 (SEG_A), U8.11 (a), U9.11 (a)
/7seg 3-4/S2: U7.16 (SEG_B), U8.7 (b), U9.7 (b)
/7seg 3-4/S3: U7.20 (SEG_C), U8.4 (c), U9.4 (c)
/7seg 3-4/S4: U7.23 (SEG_D), U8.2 (d), U9.2 (d)
/7seg 3-4/S5: U7.21 (SEG_E), U8.1 (e), U9.1 (e)
/7seg 3-4/S6: U7.15 (SEG_F), U8.10 (f), U9.10 (f)
/7seg 3-4/S7: U7.17 (SEG_G), U8.5 (g), U9.5 (g)
/7seg 3-4/S8: U7.22 (SEG_DP), U8.3 (DPX), U9.3 (DPX)
/7seg 5-6/CC1: U10.2 (DIG_0), U12.6 (CC4)
/7seg 5-6/CC2: U10.11 (DIG_1), U12.8 (CC3)
/7seg 5-6/CC3: U10.6 (DIG_2), U12.9 (CC2)
/7seg 5-6/CC4: U10.7 (DIG_3), U12.12 (CC1)
/7seg 5-6/CC5: U10.3 (DIG_4), U11.6 (CC4)
/7seg 5-6/CC6: U10.10 (DIG_5), U11.8 (CC3)
/7seg 5-6/CC7: U10.5 (DIG_6), U11.9 (CC2)
/7seg 5-6/CC8: U10.8 (DIG_7), U11.12 (CC1)
/7seg 5-6/S1: U10.14 (SEG_A), U11.11 (a), U12.11 (a)
/7seg 5-6/S2: U10.16 (SEG_B), U11.7 (b), U12.7 (b)
/7seg 5-6/S3: U10.20 (SEG_C), U11.4 (c), U12.4 (c)
/7seg 5-6/S4: U10.23 (SEG_D), U11.2 (d), U12.2 (d)
/7seg 5-6/S5: U10.21 (SEG_E), U11.1 (e), U12.1 (e)
/7seg 5-6/S6: U10.15 (SEG_F), U11.10 (f), U12.10 (f)
/7seg 5-6/S7: U10.17 (SEG_G), U11.5 (g), U12.5 (g)
/7seg 5-6/S8: U10.22 (SEG_DP), U11.3 (DPX), U12.3 (DPX)
/E1A: C11.1, R16.2, U2.3 (SENSOR_VP)
/E1B: C12.2, R17.2, U2.4 (SENSOR_VN)
/E2A: C14.1, R20.2, U2.5 (IO34)
/E2B: C15.2, R21.2, U2.6 (IO35)
/E3A: C17.1, R24.2, U2.7 (IO32)
/E3B: C18.2, R25.2, U2.8 (IO33)
/E4A: C20.1, R28.2, U2.9 (IO25)
/E4B: C21.2, R29.2, U2.10 (IO26)
/E5A: C23.1, R32.2, U2.11 (IO27)
/E5B: C24.2, R33.2, U2.12 (IO14)
/RXD: R5.1, U2.34 (RXD0)
/TXD: R4.1, U2.35 (TXD0)
ALERT: J2.5, U2.15 (IO13)
CLK: U2.30 (IO18), U4.13 (CLK), U7.13 (CLK), U10.13 (CLK)
CS: U2.29 (IO5), U4.12 (LOAD), U7.12 (LOAD), U10.12 (LOAD)
DIN: R7.1, U2.37 (IO23)
GND: C1.1, C2.2, C3.2, C4.2, C5.1, C6.2, C7.1, C8.2, C9.2, C10.2, C11.2, C12.1, C13.2, C14.2, C15.1, C16.2, C17.2, C18.1, C19.2, C20.2, C21.1, C22.2, C23.2, C24.1, C25.2, D3.1 (K), H1.1, H2.1, H3.1, H4.1, H5.1, H6.1, H7.1, H8.1, H9.1, H10.1, H11.1, J1.2, J2.4, J2.6, J2.8, J2.10, J2.12, J2.14, J2.16, J3.1, R1.2, R2.1, SW1.C, SW2.C, SW3.C, SW4.C, SW5.C, TP1.1, U1.1 (GND), U2.14 (GND1), U2.32 (GND2), U2.38 (GND3), U3.4 (GND), U4.4 (GND), U4.9 (GND), U7.4 (GND), U7.9 (GND), U10.4 (GND), U10.9 (GND)
unnamed: C8.1, R6.2, R8.2, U4.19 (V+)
unnamed: C9.1, R9.2, R11.2, U7.19 (V+)
unnamed: C10.1, R12.2, R14.2, U10.19 (V+)
unnamed: D1.1 (K), R1.1
unnamed: D2.1 (K), R2.2
unnamed: D3.2 (A), R3.2
unnamed: R3.1, U2.31 (IO19)
unnamed: R4.2, U3.2 (TX)
unnamed: R5.2, U3.3 (RX)
unnamed: R7.2, U4.1 (DIN)
unnamed: R8.1, U4.18 (ISET)
unnamed: R10.2, U7.1 (DIN)
unnamed: R11.1, U7.18 (ISET)
unnamed: R13.2, U10.1 (DIN)
unnamed: R14.1, U10.18 (ISET)
unnamed: R15.1, R16.1, SW1.A
unnamed: R17.1, R18.1, SW1.B
unnamed: R19.1, R20.1, SW2.A
unnamed: R21.1, R22.1, SW2.B
unnamed: R23.1, R24.1, SW3.A
unnamed: R25.1, R26.1, SW3.B
unnamed: R27.1, R28.1, SW4.A
unnamed: R29.1, R30.1, SW4.B
unnamed: R31.1, R32.1, SW5.A
unnamed: R33.1, R34.1, SW5.B
unnamed: C5.2, U2.1 (3V3)
unnamed: J3.2, U3.A (A+)
unnamed: J3.3, U3.B (B-)
PWM1: J2.15, U2.28 (IO17)
PWM2: J2.13, U2.27 (IO16)
PWM3: J2.11, U2.26 (IO4)
PWM4: J2.9, U2.24 (IO2)
PWM5: J2.7, U2.23 (IO15)
SCL: J2.1, U2.36 (IO22)
SDA: J2.3, U2.33 (IO21)
