vaidastal/DZF-6020-UV-power-addon/(commit log)

2024-08-30 adding power board
    [pwr.kicad_pcb, pwr.kicad_sch, pwr_ch.kicad_sch]
2024-08-30 remove missing models from footprints
    [pwr.kicad_pcb]
2024-09-02 finalizing design
    [pwr.kicad_pcb, pwr.kicad_sch, pwr_ch.kicad_sch]
2024-09-02 generating production files for power board
    [bom.csv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]
2024-09-10 adding user interface board
    [bom.csv, bom_lcsc.csv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]
2024-10-09 fixing a lot of stuff in power board
    [bom.csv, bom_lcsc.csv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]
2024-11-15 rs485 connector and minor silkscreen and led values fixes
    [bom.csv, bom_lcsc.csv, pwr.kicad_pcb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]
2025-01-10 using isolated gate driver
    [bom.csv, bom_lcsc.csv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]
